Alex-ZM/TEM_Horn_Antenna/Imagenes/modelos/2025_02_20-Placas/Antena2.png

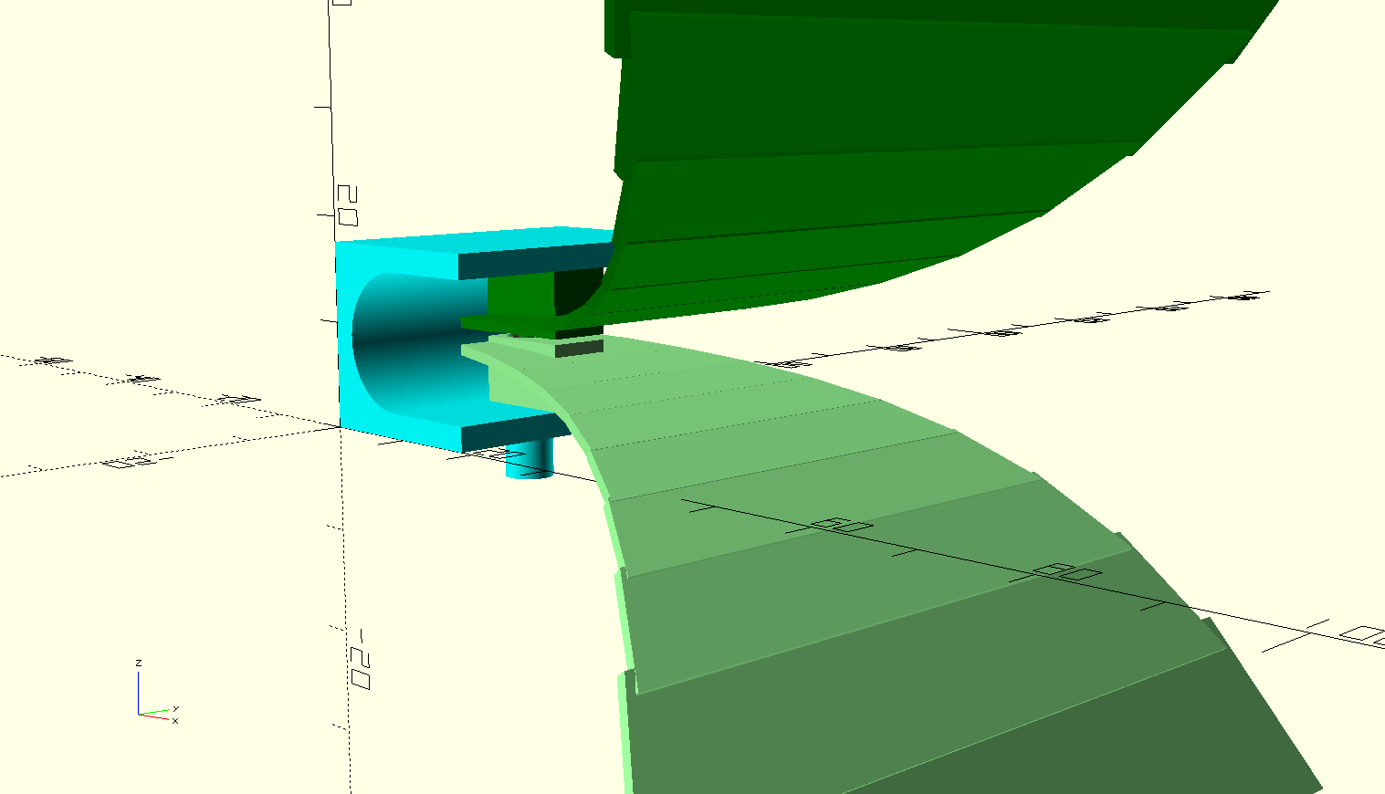
Imagenes/modelos/2025_02_20-Placas/Antena2.png
