Alex-ZM/TEM_Horn_Antenna/Imagenes/modelos/2025_02_21-ExtrudeFunctYSuavizado/placa/pl1.png

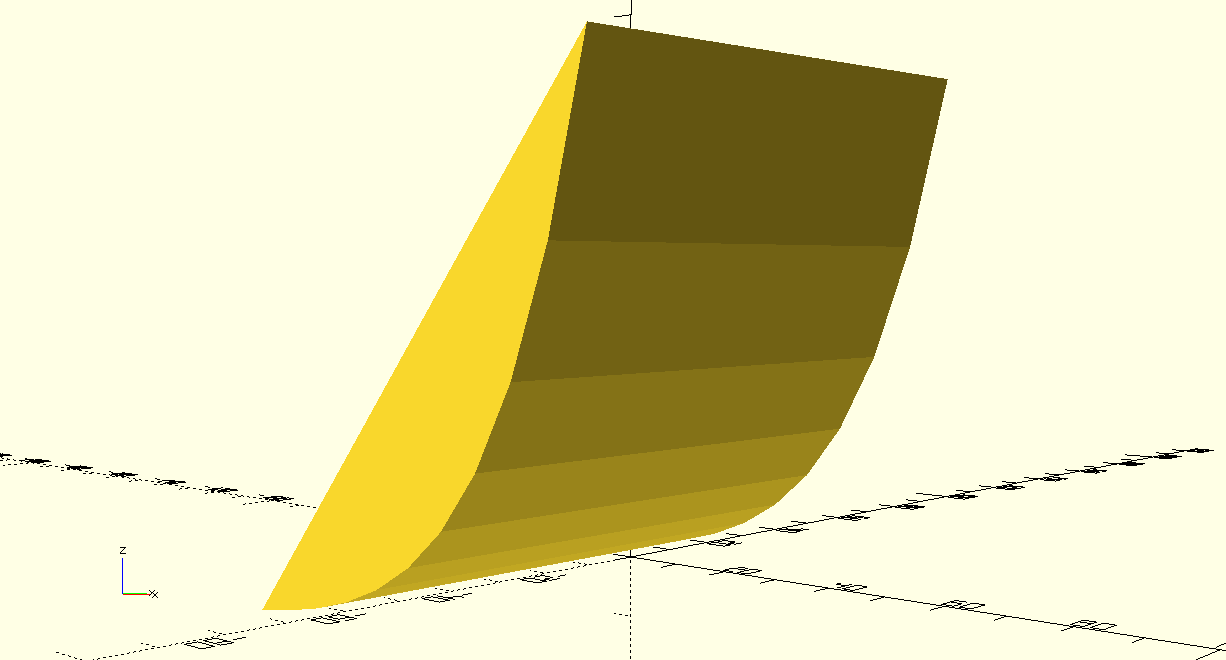
Imagenes/modelos/2025_02_21-ExtrudeFunctYSuavizado/placa/pl1.png
