Alex-ZM/TEM_Horn_Antenna/Imagenes/modelos/2025_02_21-ExtrudeFunctYSuavizado/placa/pl4.png

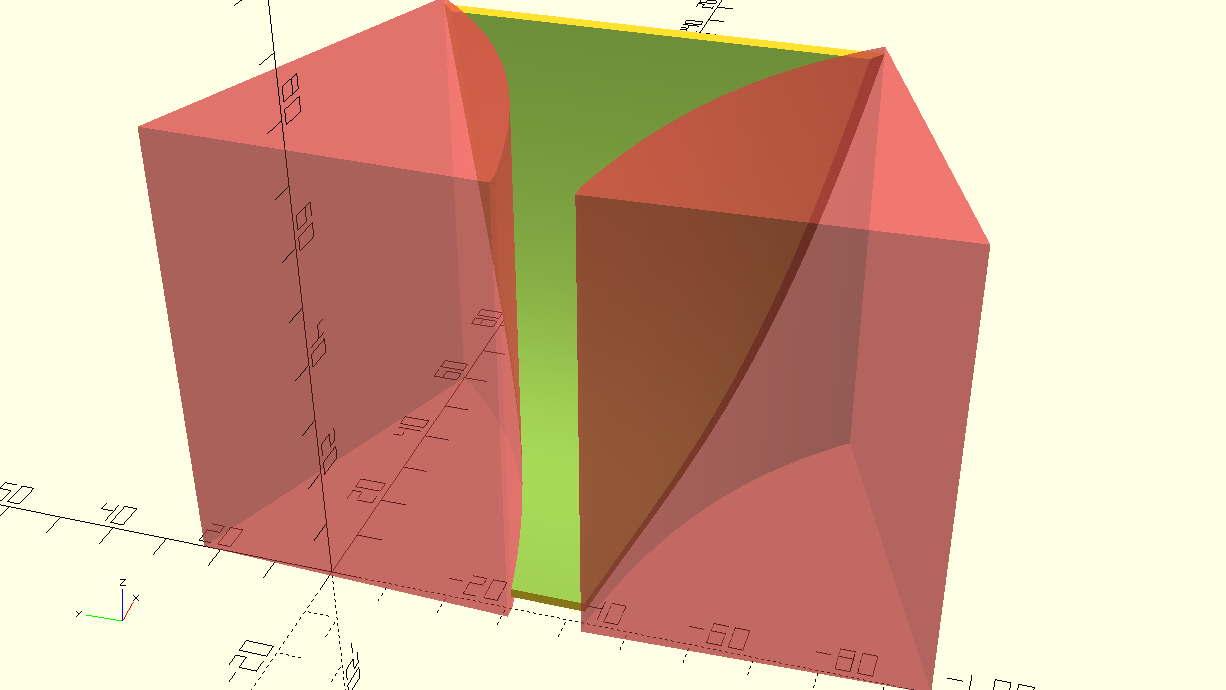
Imagenes/modelos/2025_02_21-ExtrudeFunctYSuavizado/placa/pl4.png
