Alex-ZM/TEM_Horn_Antenna/Imagenes/modelos/2025_02_23-VivaldiPalmera/PalmTreeVivaldi.png

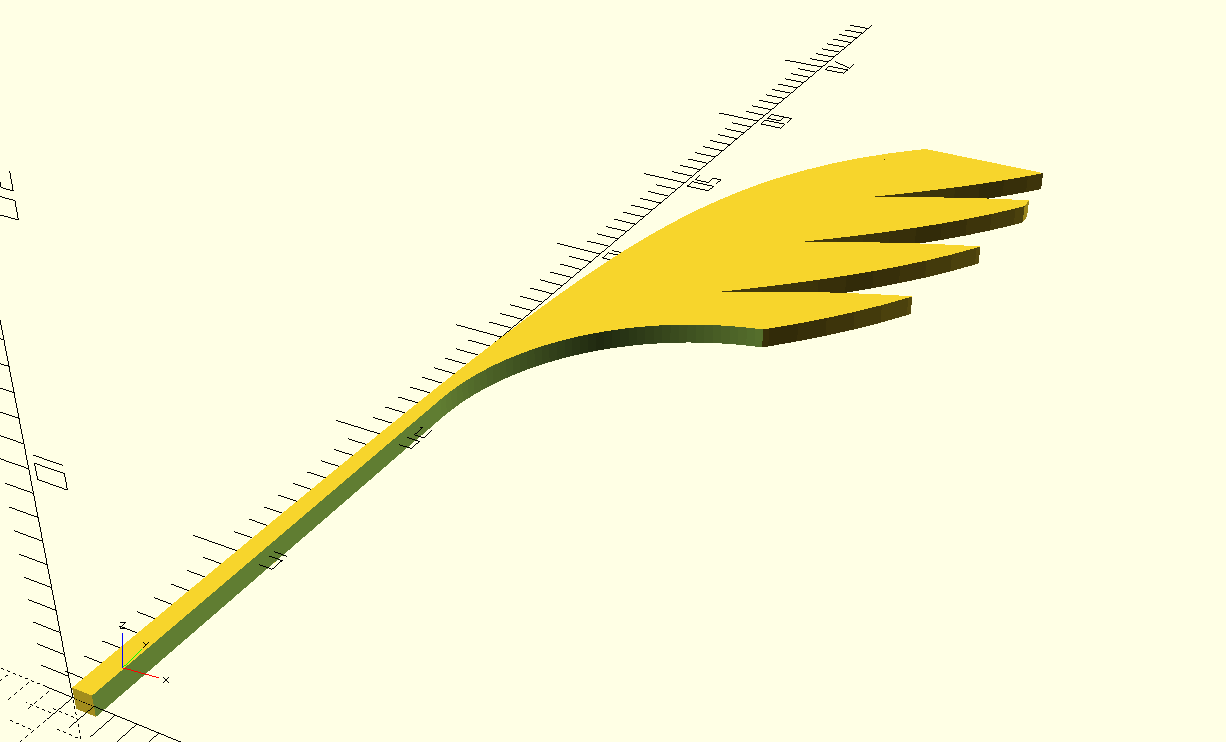
Imagenes/modelos/2025_02_23-VivaldiPalmera/PalmTreeVivaldi.png
