Alex-ZM/TEM_Horn_Antenna/Imagenes/modelos/2025_03_15-ConectorV1/aletas.png

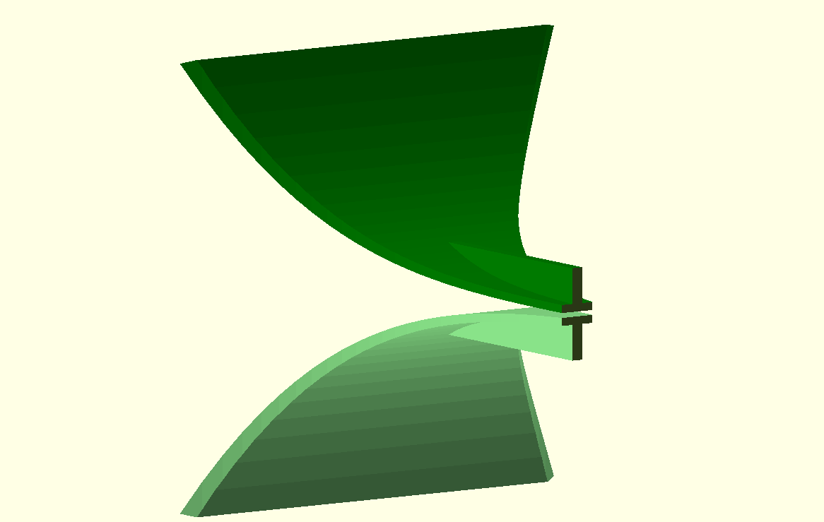
Imagenes/modelos/2025_03_15-ConectorV1/aletas.png
