Alex-ZM/TEM_Horn_Antenna/Imagenes/modelos/SoporteFeed/1.png

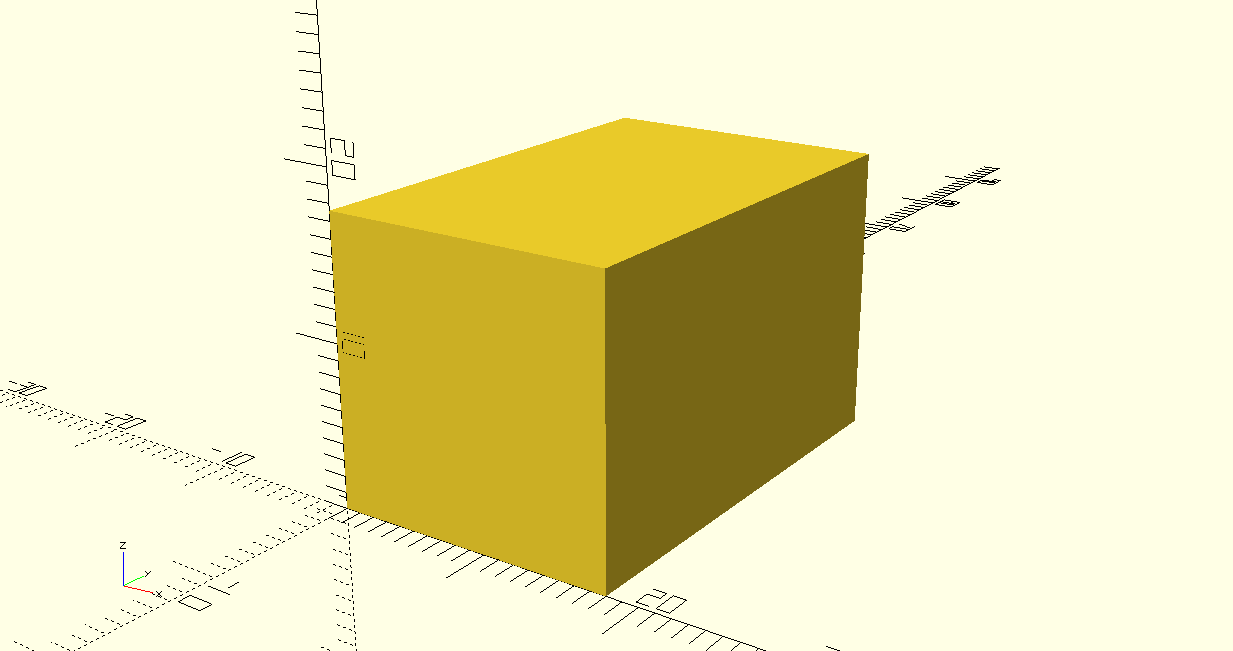
Imagenes/modelos/SoporteFeed/1.png
