Alex-ZM/TEM_Horn_Antenna/Imagenes/modelos/SoporteFeed/3.png

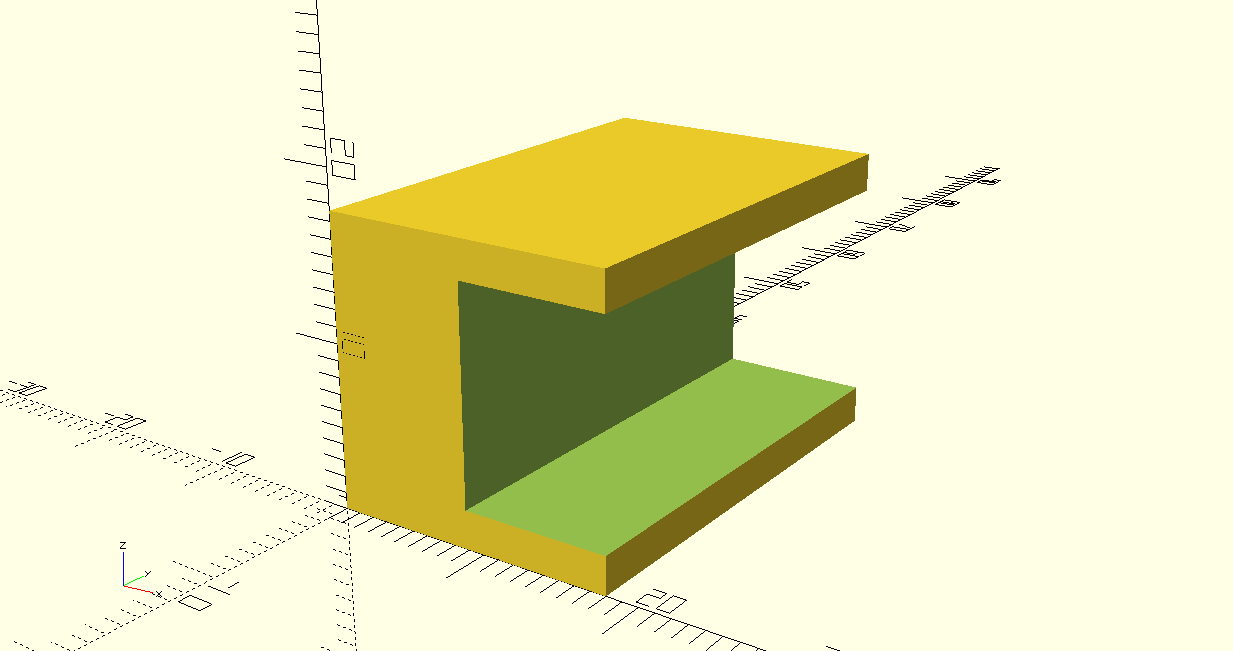
Imagenes/modelos/SoporteFeed/3.png
