Alex-ZM/TEM_Horn_Antenna/LaTeX/img/fundTeo/dipolo2.png

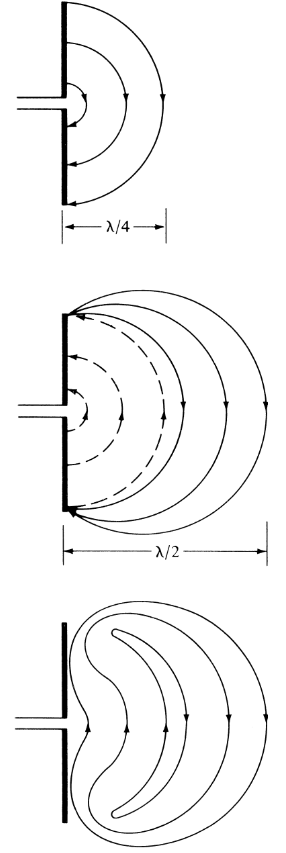
LaTeX/img/fundTeo/dipolo2.png
