Alex-ZM/TEM_Horn_Antenna/LaTeX/img/modelos/2025_02_21-ExtrudeFunctYSuavizado/Antena3Suave.png

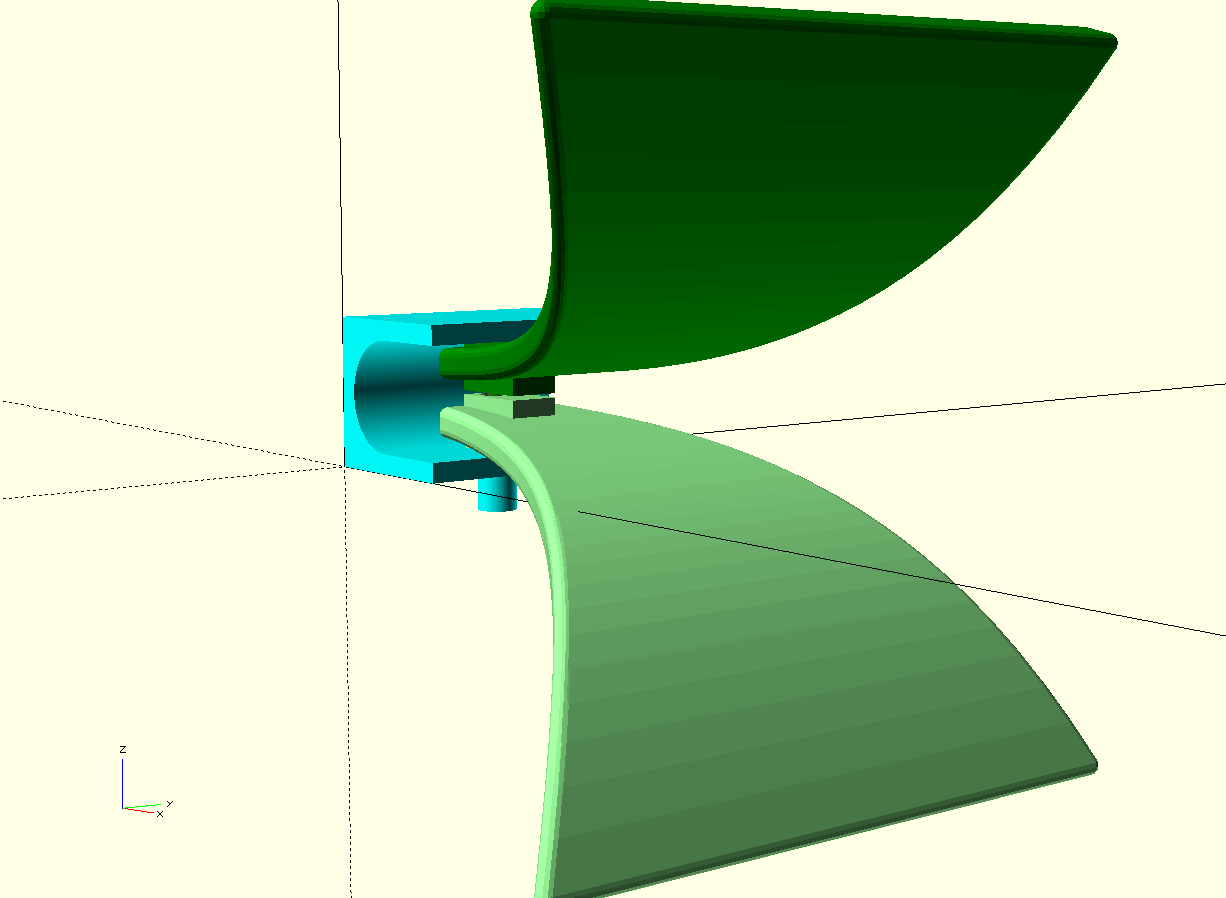
LaTeX/img/modelos/2025_02_21-ExtrudeFunctYSuavizado/Antena3Suave.png
