Alex-ZM/TEM_Horn_Antenna/LaTeX/img/modelos/2025_03_19-ConectorV2/2025_04_02-anguloBordes.png

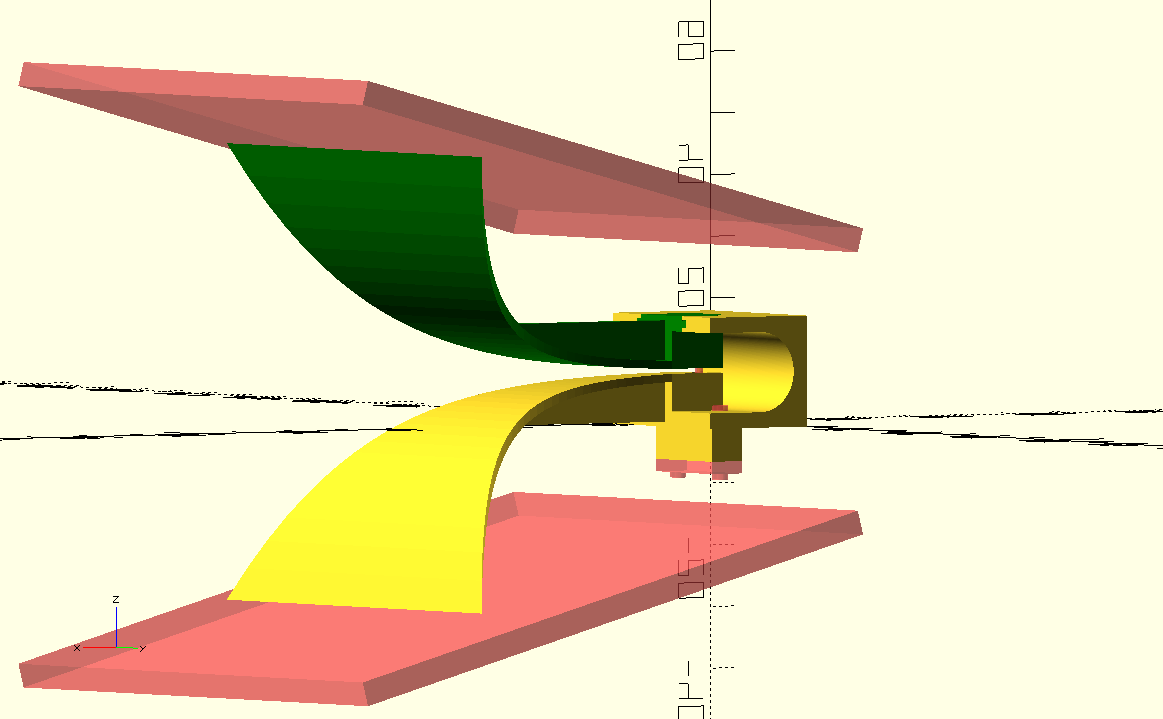
LaTeX/img/modelos/2025_03_19-ConectorV2/2025_04_02-anguloBordes.png
