Alex-ZM/TEM_Horn_Antenna/LaTeX/img/modelos/2025_03_19-ConectorV2/conector.png

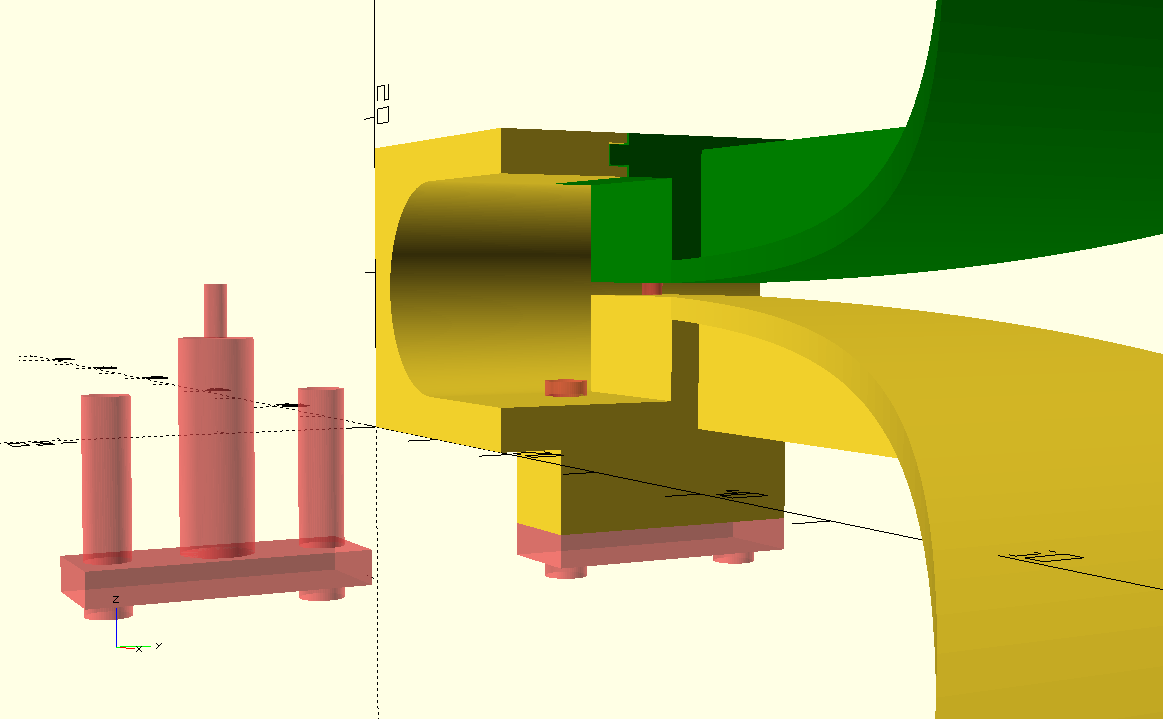
LaTeX/img/modelos/2025_03_19-ConectorV2/conector.png
