Alex-ZM/TEM_Horn_Antenna/(list of files, cad)

Other CAD files:
Antena3.scad
conectorV2.scad
Crestas.scad
testPlacas.scad
conectorV1.scad
