Alex-ZM/TEM_Horn_Antenna/(commit log)

2025-03-19 Conector V2
    [conectorV1.scad, conectorV2.scad]
2025-03-25 Fotos bibliomaker (test impresión filamento)
2025-04-02 ajuste bordes
    [conectorV2.scad]
2025-06-08 fix parámetros por defecto
    [conectorV2.scad]
2025-06-15 subida de recursos faltantes
