Alex-ZM/TEM_Horn_Antenna/LaTeX/img/Metalizado/resultadosMetalizado2.jpg

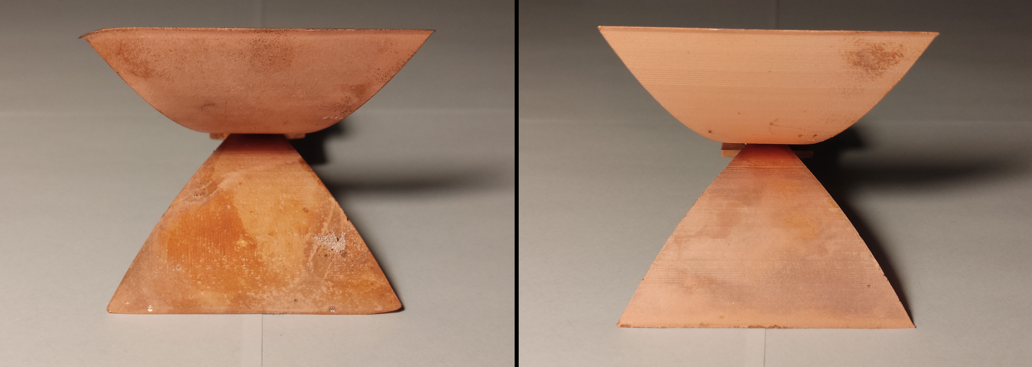
[picture p26: LaTeX/img/Metalizado/resultadosMetalizado2.jpg]
LaTeX/img/Metalizado/resultadosMetalizado2.jpg
